shirriff/ul914/nor.sch

## KiCad design nor.sch (2019-05-22)

Schematic: nor.sch

Parts:
Q1, Q2, Q3, Q4: Q_NPN_BEC; TO-264_Vertical
R1, R2, R3, R4, R5, R6: SPARKFUN-RESISTORS_4.7KOHM-0603-1_10W-1%; R_Axial_DIN0207_L6.3mm_D2.5mm_P10.16mm_Horizontal
TP1, TP2, TP3, TP4, TP5, TP6, TP7, TP8: TestPoint; SolderWirePad_single_0-8mmDrill
